fablabcb/fablock/README.md

# fablock

This is a mechanic to open our window via a telegram bot to get access to the keys to our workshop.
