fablabcb/fablock/Mechanik/README.md

# fablock mechanics

## TODO:

- [ ] complete README
- [ ] add photos of the mechanic
- [ ] add parts list
- [ ] add description about how to assemble
- [ ] add Fusion360 files for the mounting plate (only dxf file included now) 
- [ ] add files for the 3d printed stoppers mounted to the plate
