fablabcb/fablock/Mechanik/mounting_board/3D-Modell Logbuch.md

# Fablock Platte Fräsmodell Optimierungen

- ~~Motor braucht noch ø 22mm Aussparung um die Antriebswelle herum (dort hat der Motor eine kleine Erhöhung)~~
- ~~Befestigungsschrauben für Zahnrad Kuggellager können ca 3mm näher zur Kante~~
- ~~Motor Kabeldurchführung nach unten oder seitlich vom Motor~~
