fablabcb/fablock/Mechanik/mounting_board/fablock_Platte_Schrauben.md

# Fablock Platte Schrauben

### Motor Befestigung

- 4x M3 Zylinderkopfschraube mit Innensechskant 10mm (8mm Platte + 3mm max. Einschraubtiefe an Motor)

### Raspberry Befestigung

- 4x M2.5 Zylinderkopfschraube mit Innensechskant 12mm (8mm Platte + 4mm Einschraubtiefe)

### Endstopp Befestigung

- 4x M2.5 Zylinderkopfschraube mit Innensechskant 14mm (8mm Platte + 6mm Endstopp)
- 4x Mutter M2.5 → wird eingeschmolzen
- 2x Linsenkopf Blechschraube 2,2mm Durchmesser 13mm lang → für seitlichen Endstopp (wird ins Holz geschraubt)

### Zahnrad Kugellager Befestigung

→ hier könnte man kleinere Schrauben verwenden, die dann auch keinen so dicken Kopf haben

- 3x M6 Linsenkopf-Schrauben mit Innensechskant 14mm (8mm Platte + Mutter)
- 3x M6 Muttern (niedrige Form, ca 3mm dick)
- 6x Unterlegscheiben (Karosseriescheibe) M6 mit 25mm Außendurchmesser
  - könnte auf M6 mit 20mm Außendurchmesser reduziert werden wenn die Bohrungen verschoben werden
