fablabcb/fablock/Elektronik/fablabcb_logo.dxf

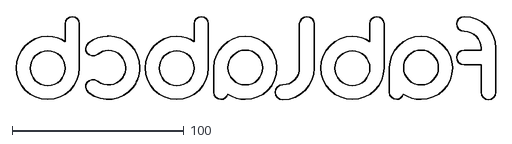
[picture p1: CAD file, 2021-02-17]
Elektronik/fablabcb_logo.dxf
279.6 x 50.7
