fablabcb/fablock/Mechanik/mounting_board/fablock_mounting_board.dxf

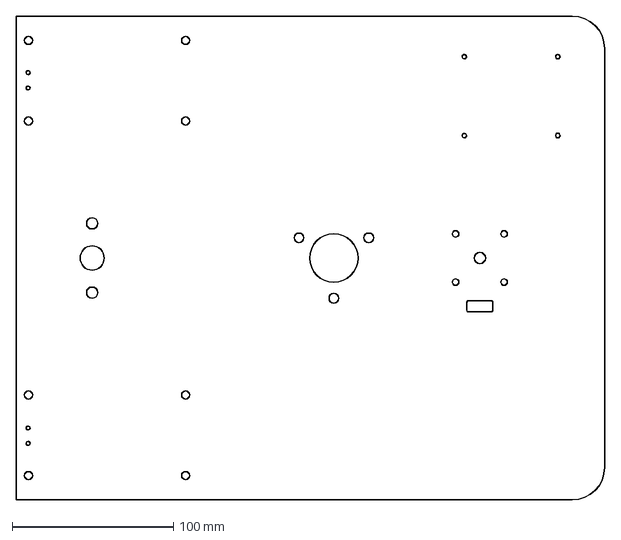
[picture p2: CAD file, 2023-11-05]
Mechanik/mounting_board/fablock_mounting_board.dxf
365.0 x 300.0 mm

Mechanik/raspberry-pi-3-b-plus-mechanical-drawing.dxf
11
5
1
N
K
E
A
13
R 007-AG0046
CMIIT ID: 2018AJ2147
KCC: R-CMM-P2R-RPI3P
IFETEL: RCPRARA18-1020
IN CHINA
PCB MADE
PEN
IC: 20953-RPI3P
FCC ID: 2ABCB-RPI3BP
Licensed from
Proant AB
Uses technology
PoE
c Raspberry Pi 2017
Raspberry Pi 3 Model B
MICRO SD CARD
HDMI
BOTOM LEGEND
BOTTOM ASSEMBLY
TOP LEGEND
TOP ASSEMBLY
Made in the UK
A/V
GPIO
USB
ETHERNET
PWR IN
DISPLAY
CAMERA
RUN
ACT
PWR
