fablabcb/fablock/Mechanik/5TGear_5mmHub_wScrew.scad

$fn=100;
include <parametric_involute_gear_v5.0.scad>;
include <teardrop.scad>;
include <hub.scad>;

shaftDiameter = 5.3; // the shaft at the center, will be subtracted from the pulley. Better be too small than too wide.
hubDiameter = 20; // if the hub or timing pulley is big enough to fit a nut, this will be embedded.
hubHeight = 8; // the hub is the thick cylinder connected to the pulley to allow a set screw to go through or as a collar for a nut.
flanges = 0; // the rims that keep the belt from going anywhere
hubSetScewDiameter = 3; // use either a set screw or nut on a shaft. Set to 0 to not use a set screw.
numSetScrews = 1;


difference(){
  union(){
    translate([0,0,-6]) gear (number_of_teeth=5,
      circular_pitch=500,
      gear_thickness = 6,
      rim_thickness = 6,
      hub_thickness = 6,
      circles=0);
    hub(hubDiameter,hubHeight,hubSetScewDiameter);
  }
 cylinder(d=5.3, h=30, center=true);
  
};
			


  
