fablabcb/fablock/Mechanik/Spacer.scad

$fn=100;
difference(){
  union(){
    cylinder(d=18, h=3.2);
  }
cube([7.4, 7.4, 40], center=true);
};
