fablabcb/fablock/(list of files, cad)

Other CAD files:
Mechanik/parametric_involute_gear_v5.0.scad
Mechanik/parametric_involute_gear_v5.0_viertel.scad
Mechanik/60TGear_8mmHub_wScrew.scad
Mechanik/6TGear_8mmHub_wScrew.scad
Mechanik/7TGear_8mmHub_wScrew.scad
Mechanik/8TGear_8mmHub_wScrew.scad
