fablabcb/fablock/Elektronik/raspberrypi_hat.kicad_pcb

## KiCad design Elektronik/raspberrypi_hat.kicad_pcb (2021-05-18)

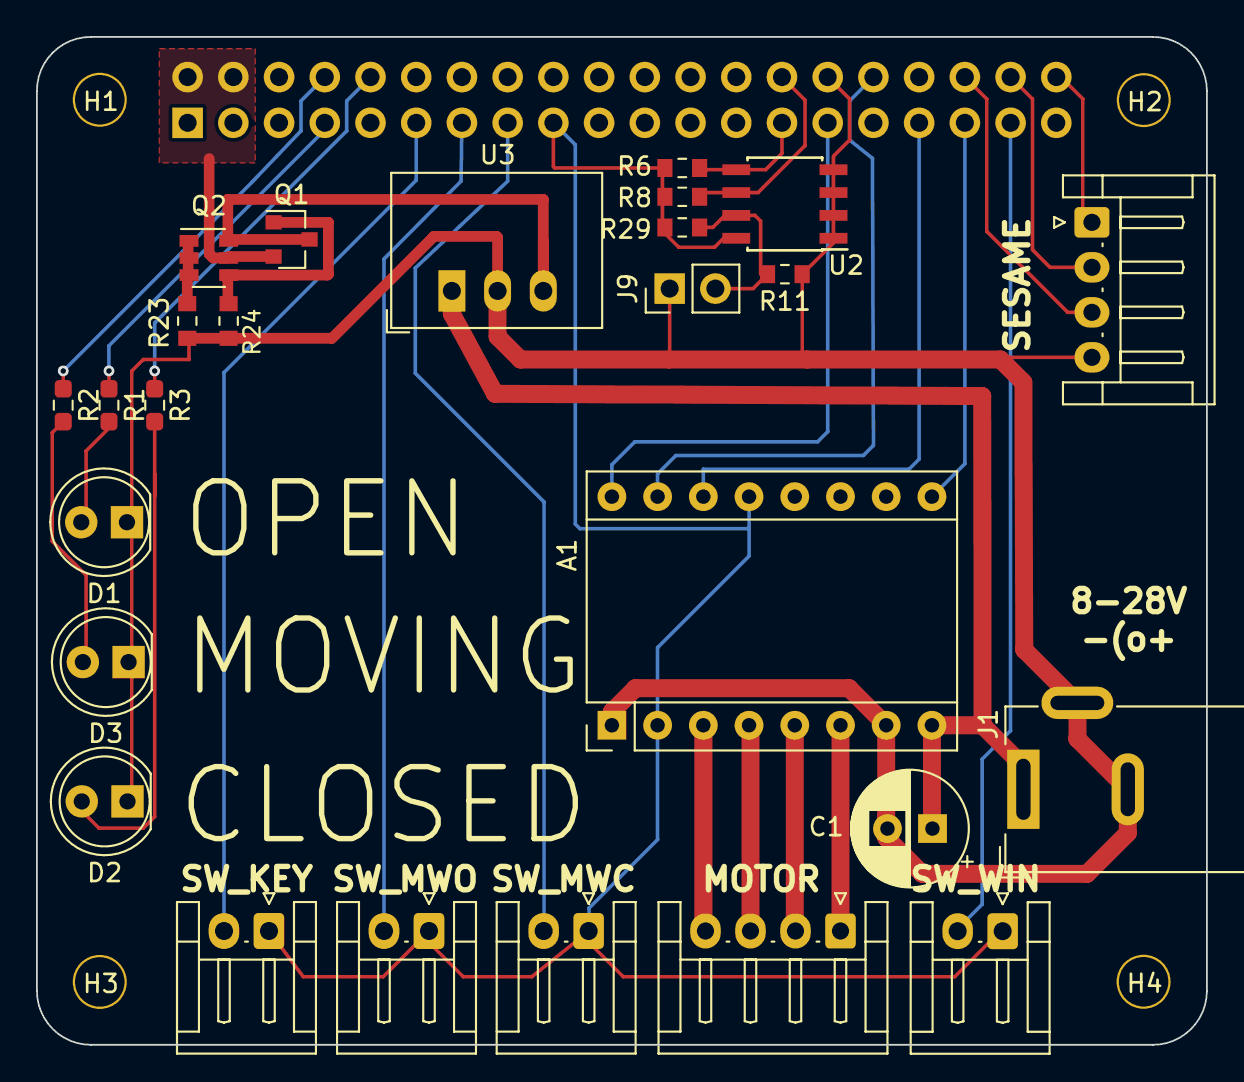
[picture p4: board raspberrypi_hat.kicad_pcb from above]

Board: 2 copper layers, 65.0 x 56.0 mm, 31 parts (1 on the bottom side), 31 nets.

Parts:
A1: Pololu_Breakout_A4988; Pololu_Breakout-16_15.2x20.3mm
C1: 100UF-63V-20%_ELECT_; CP_Radial_D6.3mm_P2.50mm
D1: LED_RED; LED_D5.0mm
D2: LED_GREEN; LED_D5.0mm
D3: LED_YELLOW; LED_D5.0mm
H1, H2, H3, H4: 3mm_Mounting_Hole; NPTH_3mm_ID
J1: Barrel_Jack_Switch; BarrelJack_Wuerth_6941xx301002
J2, J6: Conn_01x04_Male; JST_EH_S4B-EH_1x04_P2.50mm_Horizontal
J3: 40HAT; PinSocket_2x20_P2.54mm_Vertical
J8, J10, J11, J15: Conn_01x02_Male; JST_EH_S2B-EH_1x02_P2.50mm_Horizontal
J9: CONN_01X02; PinHeader_1x02_P2.54mm_Vertical
Q1: DMG2305UX; SOT-23
Q2: DMMT5401; SOT-23-6
R1: 470; R_0603_1608Metric_Pad0.98x0.95mm_HandSolder
R2: 1K; R_0603_1608Metric_Pad0.98x0.95mm_HandSolder
R3: 680; R_0603_1608Metric_Pad0.98x0.95mm_HandSolder
R6, R8: 3.9K; R_0603_1608Metric_Pad0.84x1.00mm_HandSolder
R11: DNP; R_0603_1608Metric_Pad0.84x1.00mm_HandSolder
R23, R29: 10K; R_0603_1608Metric_Pad0.84x1.00mm_HandSolder
R24: 47K; R_0603_1608Metric_Pad0.84x1.00mm_HandSolder
U2: CAT24C32; SOIC-8_3.9x4.9mm_P1.27mm
U3: R-78E5.0-1.0; Converter_DCDC_RECOM_R-78E-0.5_THT

Connections:
/DRV_DIR: A1.16, J3.29
/DRV_EN: A1.9, J3.35
/DRV_SLP: A1.14, J3.33
/DRV_STP: A1.15, J3.32
/ID_SC_EEPROM: J3.28, R8.2, U2.6
/ID_SD_EEPROM: J3.27, R6.2, U2.5
/IN_KEY: J3.11, J15.2
/IN_MWC: J3.15, J10.2
/IN_MWO: J3.13, J8.2
/IN_WIN: J3.37, J11.2
/LED_CLOSED: J3.10, R3.1
/LED_MOVING: J3.8, R2.1
/LED_OPEN: J3.7, R1.1
/OUT_SESAME_CLOSING: J3.38, J6.2
/OUT_SESAME_OPEN: J3.36, J6.3
/OUT_SESAME_OPENING: J3.40, J6.1
/P3V3: A1.2, A1.13, J3.17, J8.1, J10.1, J11.1, J15.1, R6.1, R8.1, R29.1, U2.8
/P5V: Q1.3, Q2.6, U3.3
/P5V_HAT: J3.2, J3.4, Q1.2, Q2.5
/P12V: A1.8, C1.1, J1.1, U3.1
GND: A1.1, A1.7, C1.2, D1.1, D2.1, D3.1, J1.2, J1.3, J3.30, J6.4, J9.1, R11.2, R23.2, R24.2, U2.1, U2.2, U2.3, U2.4, U3.2
unnamed: A1.3, J2.4
unnamed: A1.4, J2.3
unnamed: A1.5, J2.2
unnamed: A1.6, J2.1
unnamed: D1.2, R1.2
unnamed: D2.2, R3.2
unnamed: D3.2, R2.2
unnamed: J9.2, R11.1, R29.2, U2.7
unnamed: Q1.1, Q2.4, R24.1
unnamed: Q2.1, Q2.2, Q2.3, R23.1
