fablabcb/fablock/(commit log)

2017-05-30 Elektronik: Motorbewegung mit einem Endstopp
2017-05-30 first working version with endstops for Locked, Unlocked and Closed
2017-05-30 Hiermit läuft der Motor jetzt
2018-02-24 Neues Arduino-Board zur Motorsteuerung von Marcel als Submodule integriert
2018-03-03 Erkennt nun ob der Schlüssel geschaltet ist
2020-12-08 Mechanik neu gedruckt
    [60TGear_8mmHub_wScrew.scad, 6TGear_5mmHub_wScrew Kopie.scad, hub.scad, parametric_involute_gear_v5.0.scad]
2020-12-22 Raspberry-Motorsteuerung kicad projekt hinzugefügt
    [raspberrypi_hat.kicad_pcb, raspberrypi_hat.sch]
2021-01-05 TODO bearbeitet
    [raspberrypi_hat.sch]
2021-01-19 finished schema, started pcb
    [raspberrypi_hat.kicad_pcb, raspberrypi_hat.sch]
2021-01-26 finished pcb layout
    [fablabcb_logo.dxf, raspberrypi_hat.kicad_pcb, raspberrypi_hat.sch]
2021-02-09 added gerber files, bom
    [raspberrypi_hat-B_Cu.gbr, raspberrypi_hat-B_SilkS.gbr, raspberrypi_hat-Edge_Cuts.gbr, raspberrypi_hat-F_Cu.gbr, raspberrypi_hat-F_SilkS.gbr, raspberrypi_hat-In1_Cu.gbr, raspberrypi_hat-In2_Cu.gbr, raspberrypi_hat-NPTH-drl-drl_map.gbr]
2021-02-16 improved barrel-jack/capacitor footprint and 12v lanes
    [raspberrypi_hat-B_Cu.gbr, raspberrypi_hat-B_Mask.gbr, raspberrypi_hat-B_SilkS.gbr, raspberrypi_hat-Edge_Cuts.gbr, raspberrypi_hat-F_Cu.gbr, raspberrypi_hat-F_Mask.gbr, raspberrypi_hat-F_SilkS.gbr, raspberrypi_hat-In1_Cu.gbr]
2021-02-16 changed to 2 layer board
    [raspberrypi_hat-B_Cu.gbr, raspberrypi_hat-B_Mask.gbr, raspberrypi_hat-B_SilkS.gbr, raspberrypi_hat-Edge_Cuts.gbr, raspberrypi_hat-F_Cu.gbr, raspberrypi_hat-F_Mask.gbr, raspberrypi_hat-F_SilkS.gbr, raspberrypi_hat-NPTH.drl]
2021-02-16 changed to 2 layer board (4reals)
    [raspberrypi_hat.kicad_pcb]
2021-02-18 increased via size to 0.6/0.3mm
    [raspberrypi_hat-B_Cu.gbr, raspberrypi_hat-B_Mask.gbr, raspberrypi_hat-B_SilkS.gbr, raspberrypi_hat-Edge_Cuts.gbr, raspberrypi_hat-F_Cu.gbr, raspberrypi_hat-F_Mask.gbr, raspberrypi_hat-F_SilkS.gbr, raspberrypi_hat-NPTH.drl]
2021-03-18 fixed second SW_KEY to SW_WIN in silkscreen
    [raspberrypi_hat.kicad_pcb]
2021-03-30 fixed LED orientation, C1 symbol, added 'rev 2' label, did not export gerber files
    [raspberrypi_hat.kicad_pcb, raspberrypi_hat.sch]
2021-04-20 added begin of raspberry hat software
2021-04-27 Software flow diagram initial version
2021-04-27 Software flow diagram: renamed file
2021-04-27 updated TODOs in steppermotor.py
2021-06-02 flow diagram corrected
2023-11-05 mechanics: first collection of files and started a README
    [6TGear_8mmHub_wScrew.scad, 7TGear_8mmHub_wScrew.scad, 8TGear_8mmHub_wScrew.scad, Viertelzahnrad.scad, fablock_mounting_board.dxf, parametric_involute_gear_v5.0_viertel.scad, raspberry-pi-3-b-plus-mechanical-drawing.dxf]
2023-11-05 .gitignore for kicad files
2023-11-05 moved Elektronik and Sofware folders
    [fablabcb_logo.dxf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]
2023-11-05 update to telegram bot framework 20
2023-11-05 split telegram into receiving and sending
    The telegram receiving can be run in a separate thread to not block
    the main thread, while sending must be easily possible from other
    places in the system.
2023-11-05 adjust main loop to new threading model
    Since the telegram command listener is now blocking, it must be run in a separate thread.
    The telegram thread can set an event for the main thread to open the window.
    This also allows for extending by just adding other threads that set the event to open.
2023-11-12 swap telegram into main thread
    The telegram library does some operation involving set_wakeup_fd which
    only works in the main thread.
    [main.py]
2023-11-12 dont use threading.Event for signalling
    There seems to be some issue with handling threading.Event in an
    async context. Since setting a global variable works across threads,
    this seems to be the simpler solution.
    [main.py]
2023-11-25 fixup! fix missing argument
    [rfid_listener.py]
2023-11-25 fix missing return
    If an error occurs while reading, that should not be returned to the
    higher processing layers and be counted as an invalid read.
    [MFRC522.py]
2023-11-25 fix undefined variable errors; cleanup
    [cards_sqlite.py, rfid_listener.py]
2023-11-25 move ready LED to different pin
    Using this differnt pin, the cables will be closer together on the
    GPIO pins, making it easier to make an appropriate enclosure for
    the RPi.
2023-12-02 fix reader timeouts
    The exponential part of the timeouts was previously not correctly
    implemented. This makes it so the timeout will actually be exponential.
    [rfid_listener.py]
2023-12-02 add kill switch
2023-12-02 correctly handle error when reading
    Instead of understanding this as an incorrect card, rather handle
    errors while reading as if no card was read.
    [MFRC522.py, SimpleMFRC522.py]
2023-12-16 fixup! add kill switch
    [rfid_listener.py]
2024-01-27 fix a few small bugs
    [config.py, main.py, states.py]
2024-02-14 fix reconnections
    Previously, the `con` variable was not reset, so it would not
    actually reconnect later.
    [tcp_client.py]
2025-06-01 use match/case for state machine
2025-06-01 use threading.Event instead of waiting
    Instead of busy waiting, we can use a threading.Event to wait for an unlock command in the state machine.
2025-10-03 remove unused pin setup
2025-10-03 better naming for switches
2025-10-04 rewrite in async
    To fix some issues with the async telegram handler stuff.
    [main.py, states.py]
2025-10-04 refactor handlers to allow broadcast requests
    This will allow to "tunnel" messages from handlers through the central
    server in case the handlers have some information to get out.
2025-10-06 fix sqlite3 thread error
    [rfid_listener.py]
